PA0MHE/5.7GHz-Transverter/5GHz V0_3 pcb.jpg

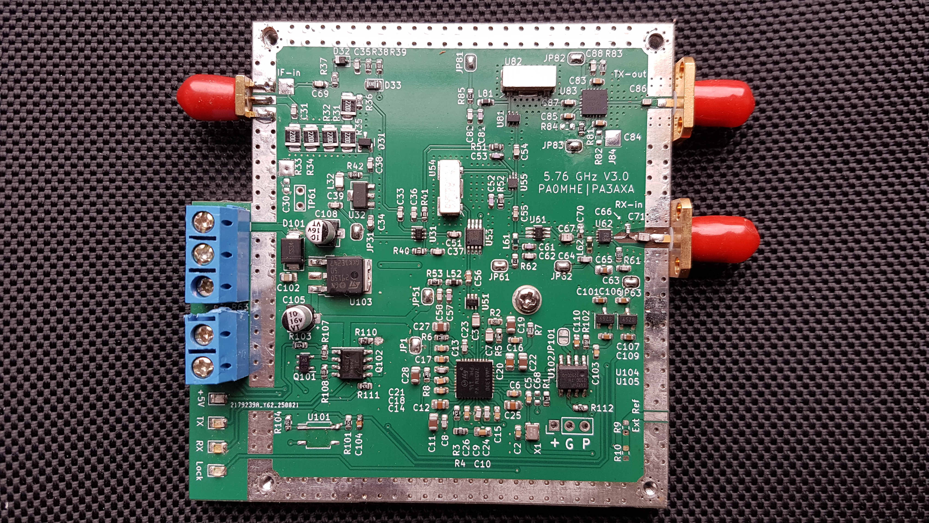
5GHz V0_3 pcb.jpg
